mocona05/seoil_uni_project/ESP32/Image/esp32_evkit.png

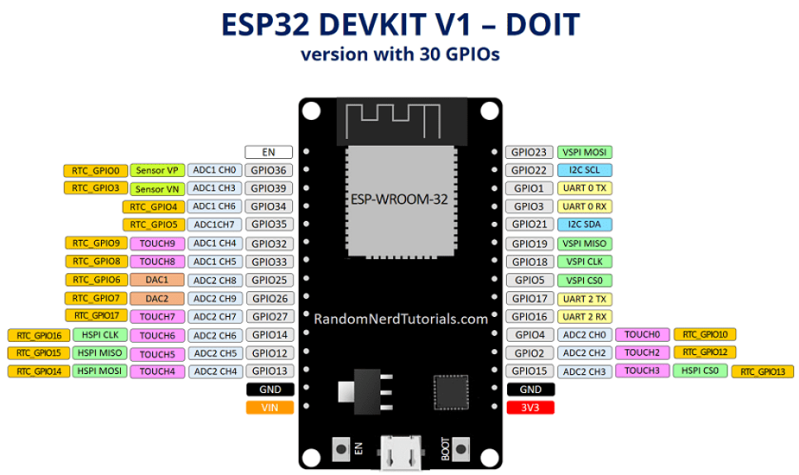
ESP32/Image/esp32_evkit.png
