mocona05/seoil_uni_project/README.md

# seoil_uni_project
서일대학 소프트웨어 공학과 C언어 심화 프로젝트 자료실

목적 : ESP32 EV-KIT 모듈을 사용하여 실습 프로젝트 진행



어댑터 PCB 디자인


어댑터 PCB 회로




온습도 표시 웹서버 실행 화면
