mocona05/seoil_uni_project/ESP32/SW/ARDUINO/Temperature_Humidity_Web_Server/src/readme.txt

hardware : esp32+SHT32 sensor

Temperature & humidity logging
Sensor Status HTML Display
