mocona05/seoil_uni_project/ESP32/DOC/회로 및 데이터쉬트/GY-21evb.pdf

GY-21

## HTU21HumiditySensorModule

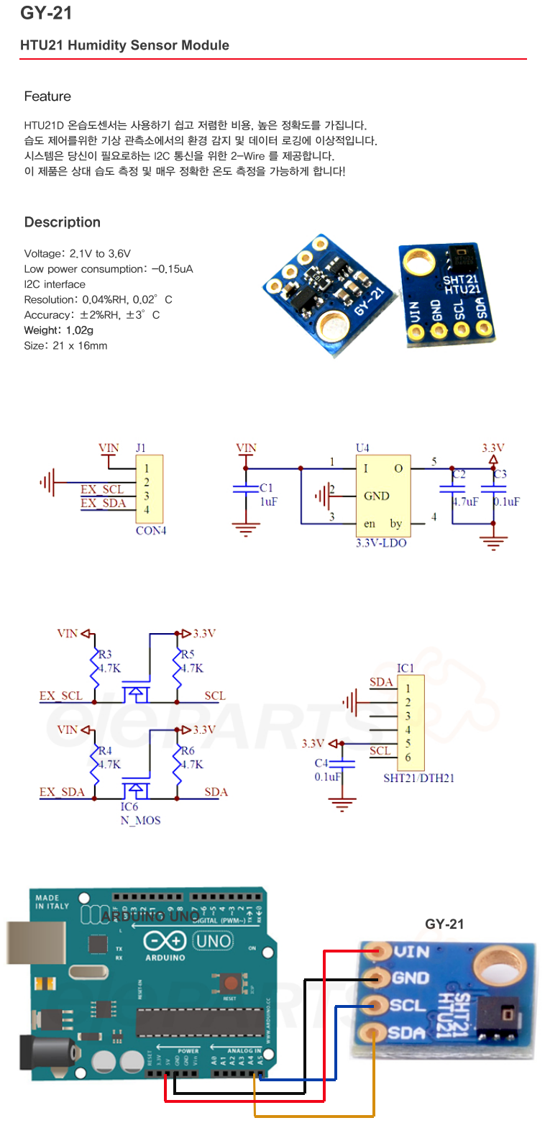
[picture p69: page 1]

## GY-21 ARDUINOUNO

HTU21D온습도센서는 사용하기 쉽고 저렴한 비용,높은 정확도를 가집니다. 습도 제어를위한 기상 관측소에서의 환경 감지 및 데이터 로깅에 이상적입니다. 시스템은 당신이 필요로하는 I2C통신을 위한 2-Wire를 제공합니다.
이 제품은 상대 습도 측정 및 매우 정확한 온도 측정을 가능하게 합니다!

### Feature

### Description

Voltage:2.1Vto3.6V
Lowpowerconsumption:-0.15uA I2Cinterface
Resolution:0.04%RH,0.02°C
Accuracy:±2%RH,±3°C
Weight:1.02g
Size:21x16mm
