mocona05/seoil_uni_project/ESP32/Image/esp32 pcb_3d_image.png

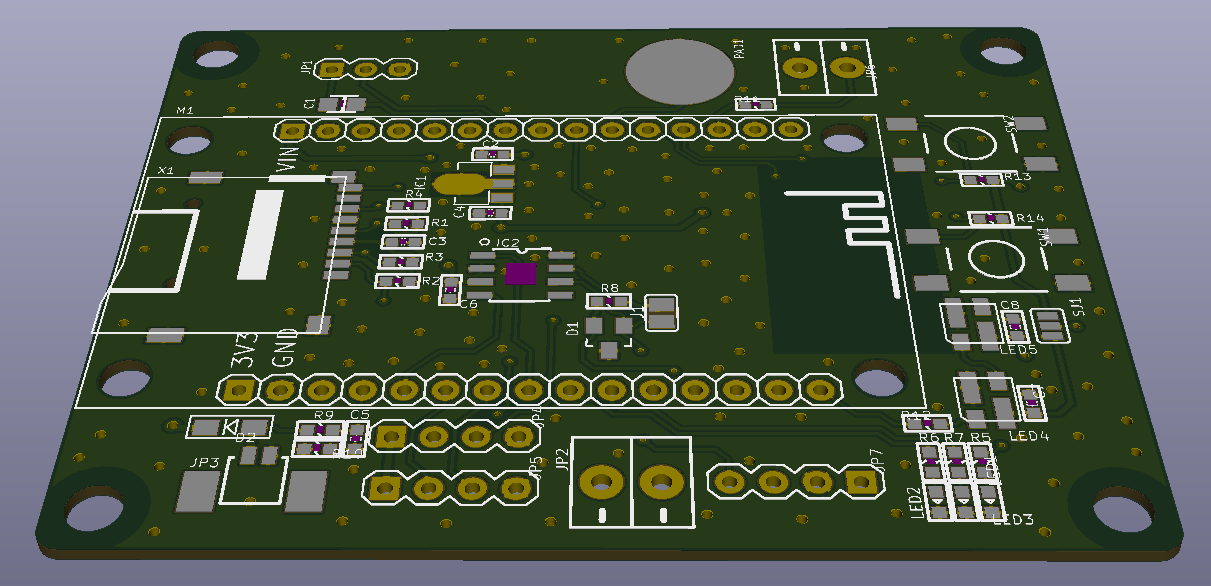
ESP32/Image/esp32 pcb_3d_image.png
