mocona05/seoil_uni_project/ESP32/Image/pcb.png

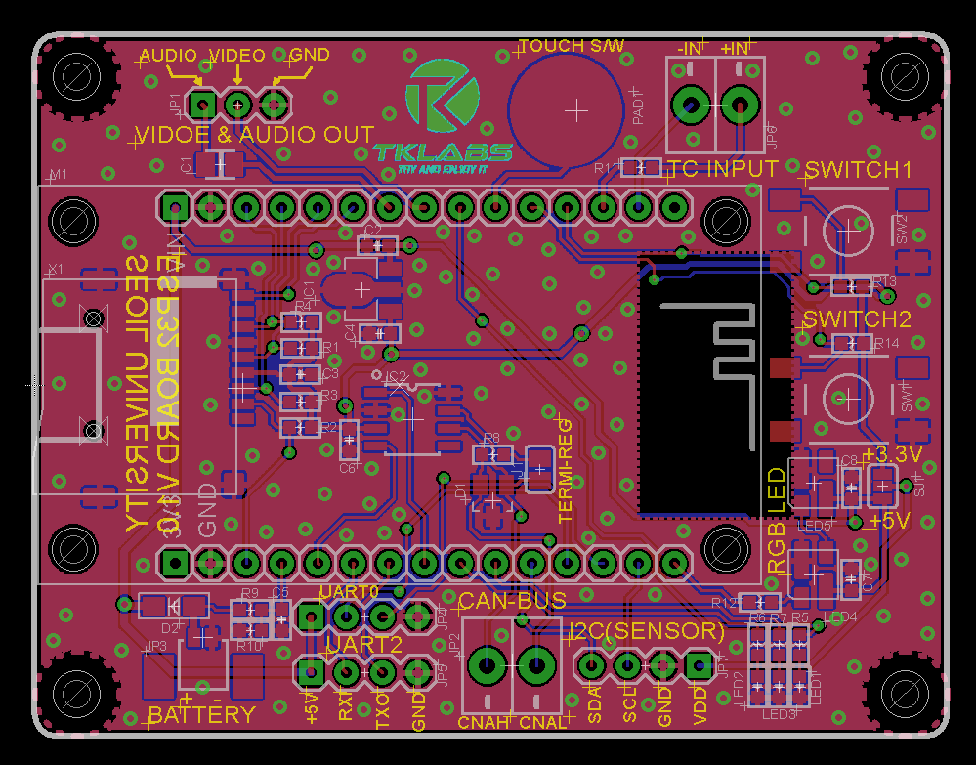
ESP32/Image/pcb.png
