mocona05/seoil_uni_project/ESP32/Image/sch.png

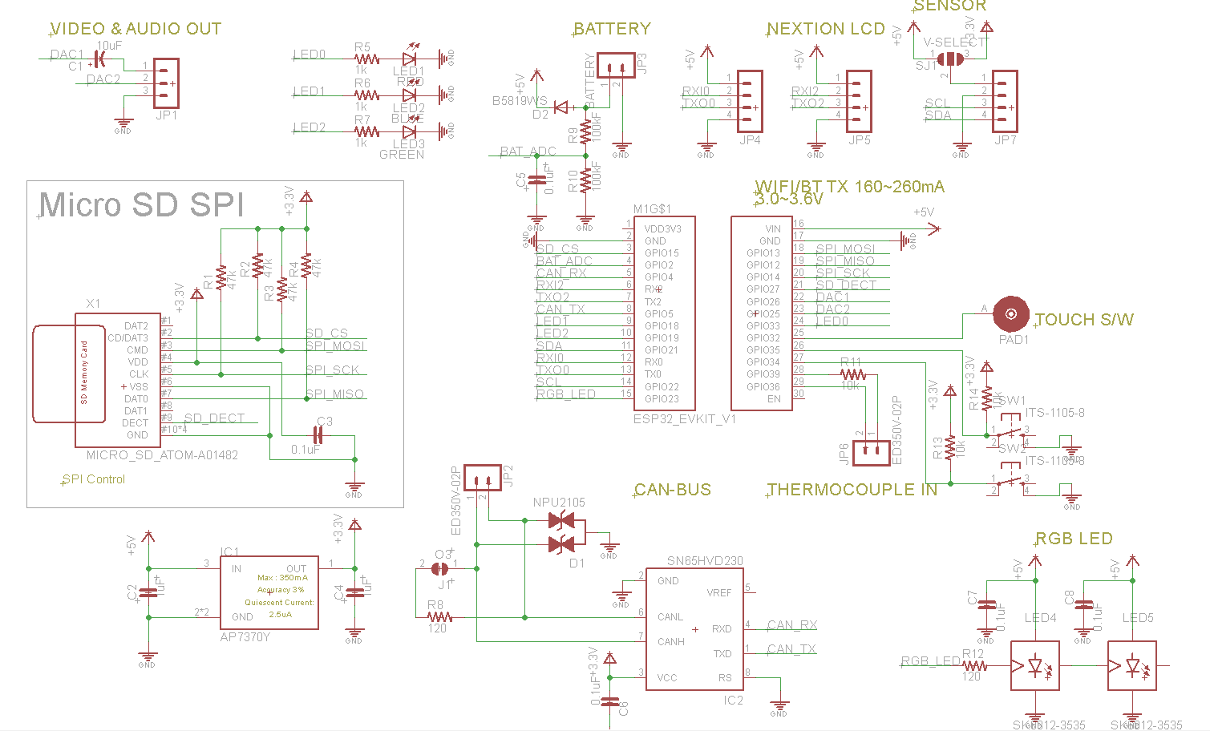
ESP32/Image/sch.png
