mocona05/seoil_uni_project/ESP32/Image/web_page.png

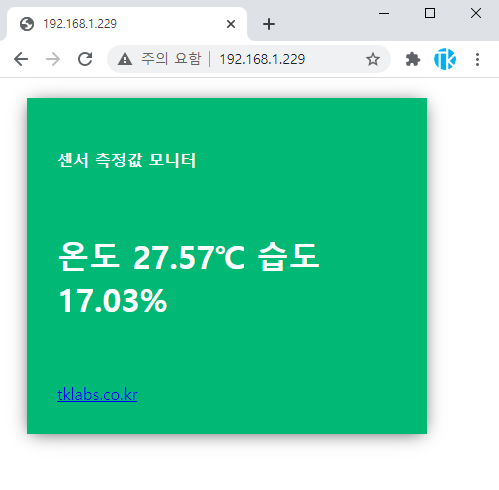
ESP32/Image/web_page.png
