mocona05/seoil_uni_project/ESP32/PCB/kicad/ESP32_EVKIT_v1.0.step

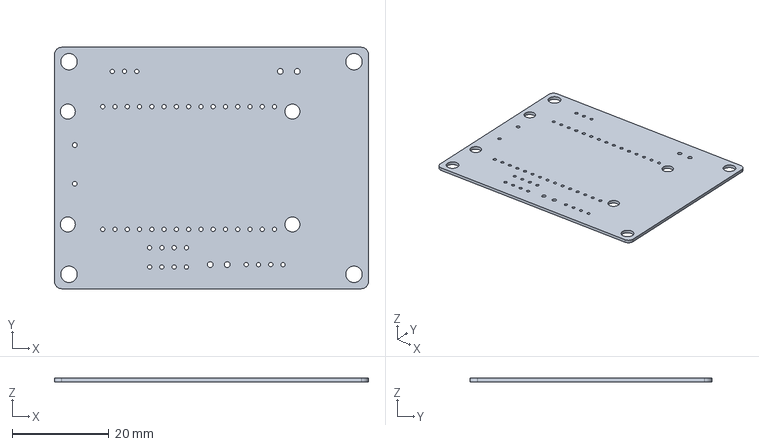
[picture p99: CAD file, 2020-10-19]
ESP32/PCB/kicad/ESP32_EVKIT_v1.0.step
65.0 x 50.0 x 0.8 mm
