mocona05/seoil_uni_project/ESP32/DOC/회로 및 데이터쉬트/esp32_Schematic Prints.pdf

# USB Part

# Power Part

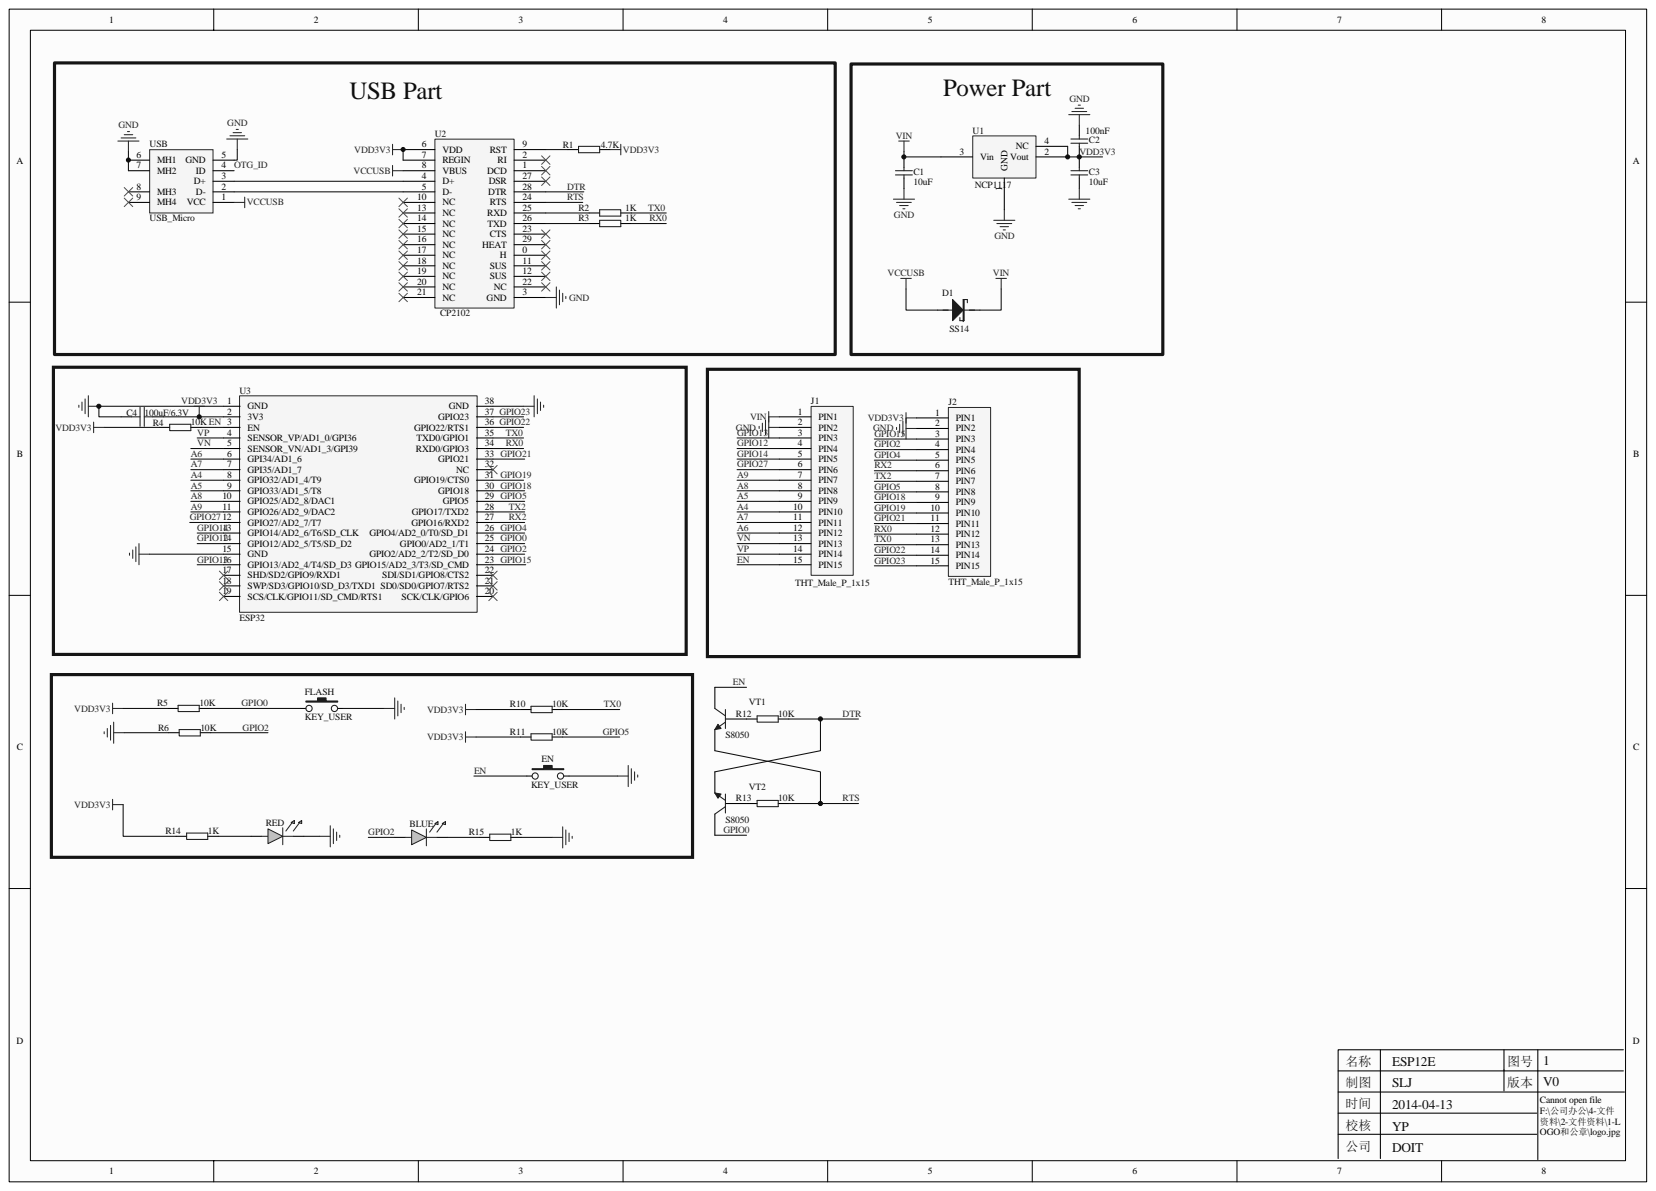
[picture p100: page 1]
