mocona05/seoil_uni_project/ESP32/PCB/EagleCAD/ESP32_EVKIT_v1.0.pdf

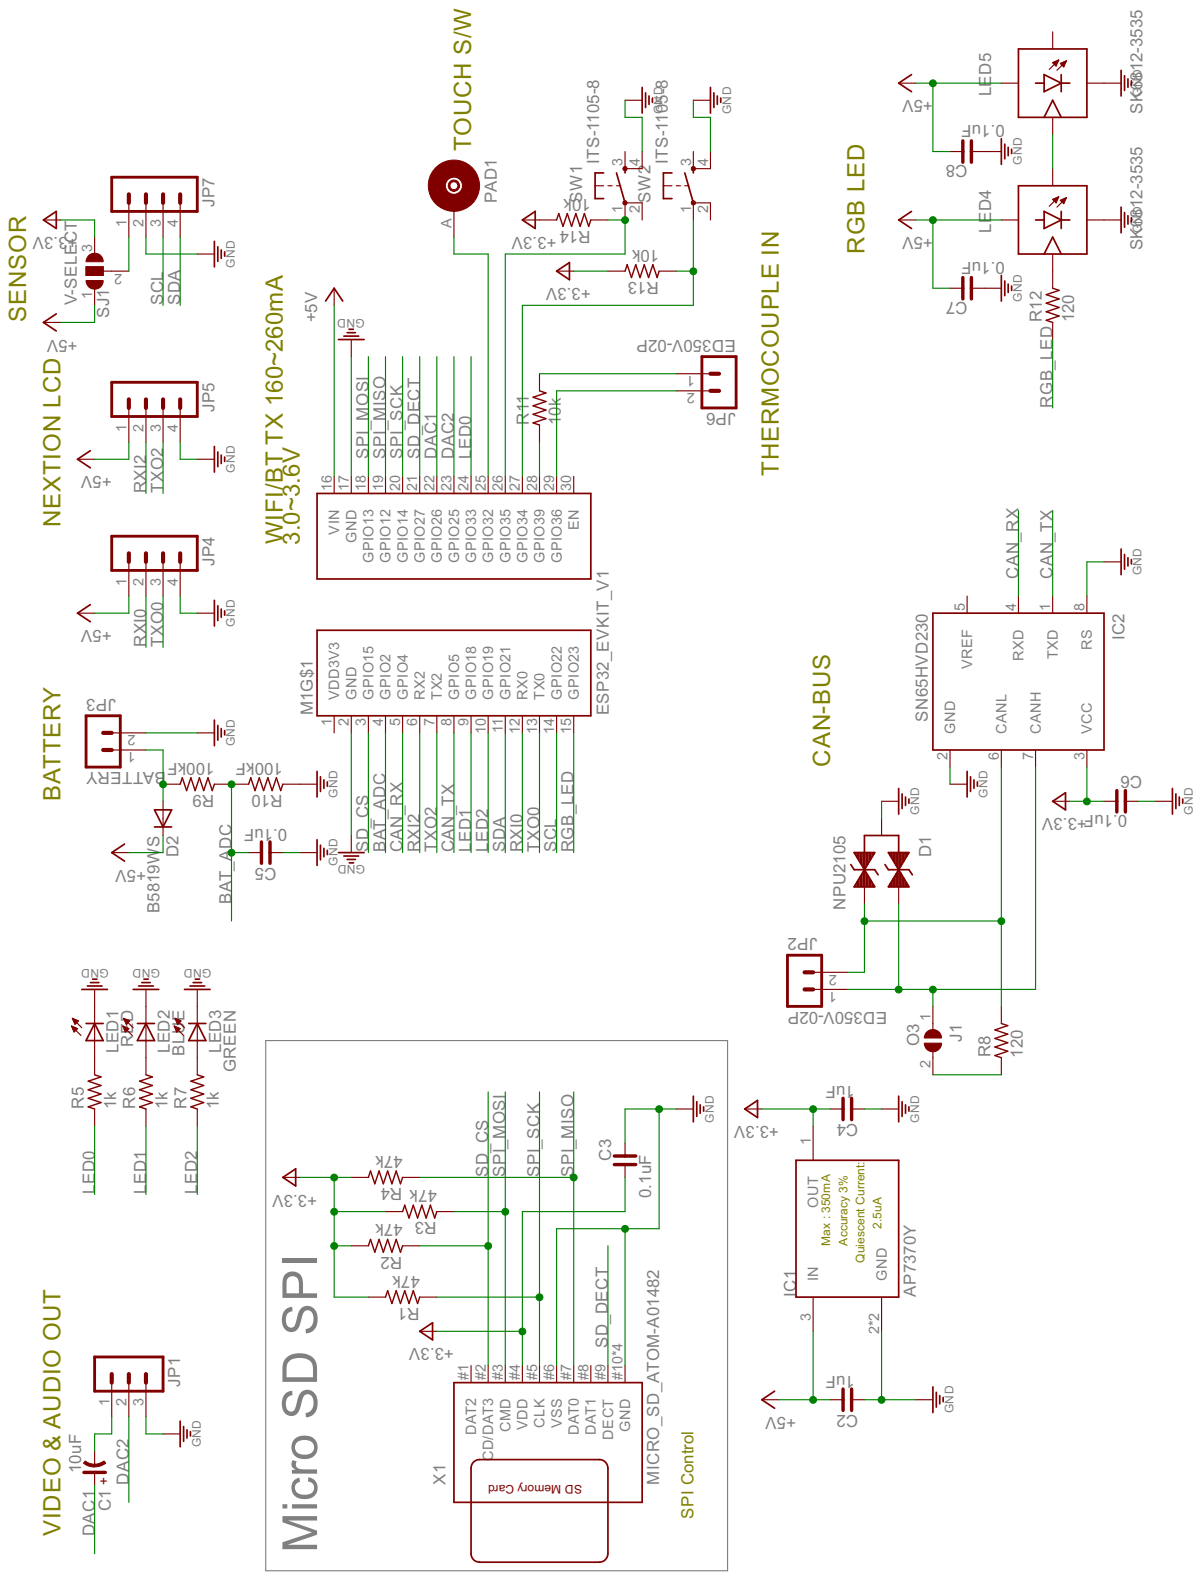
[picture p101: page 1]
