mocona05/seoil_uni_project/ESP32/PCB/EagleCAD/ESP32_EVKIT_v1.0_PCB.pdf

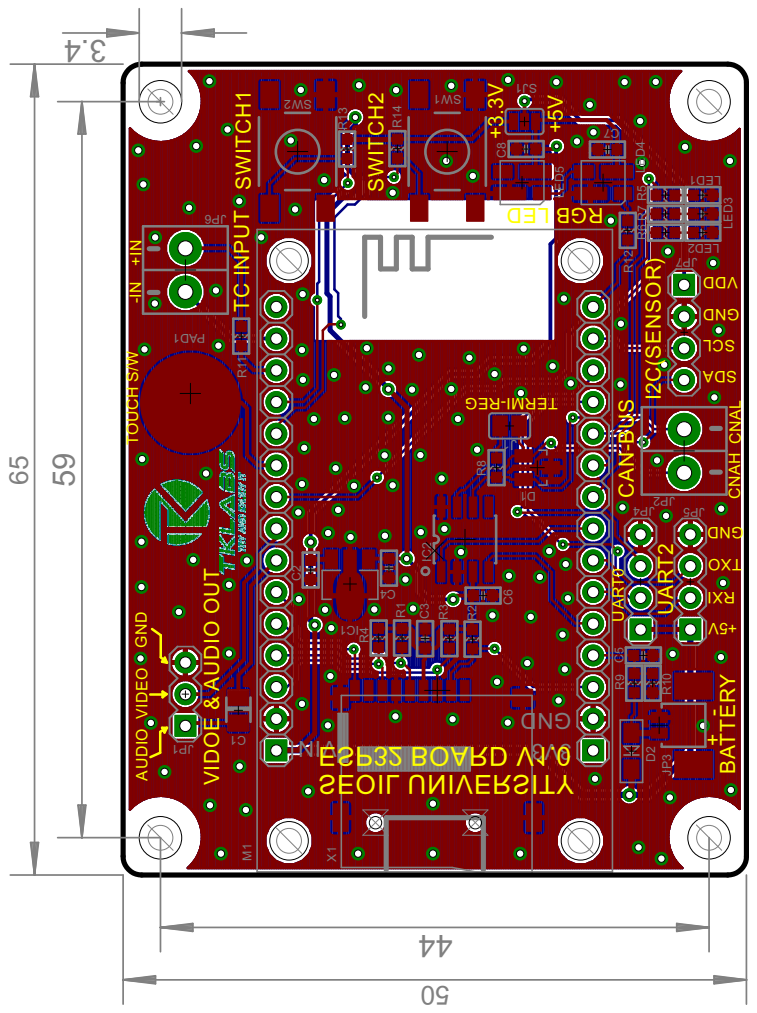
[picture p102: page 1]
