mocona05/seoil_uni_project/ESP32/PCB/kicad/ESP32_EVKIT_v1.0.kicad_pcb

## KiCad design ESP32/PCB/kicad/ESP32_EVKIT_v1.0.kicad_pcb (2020-10-19)

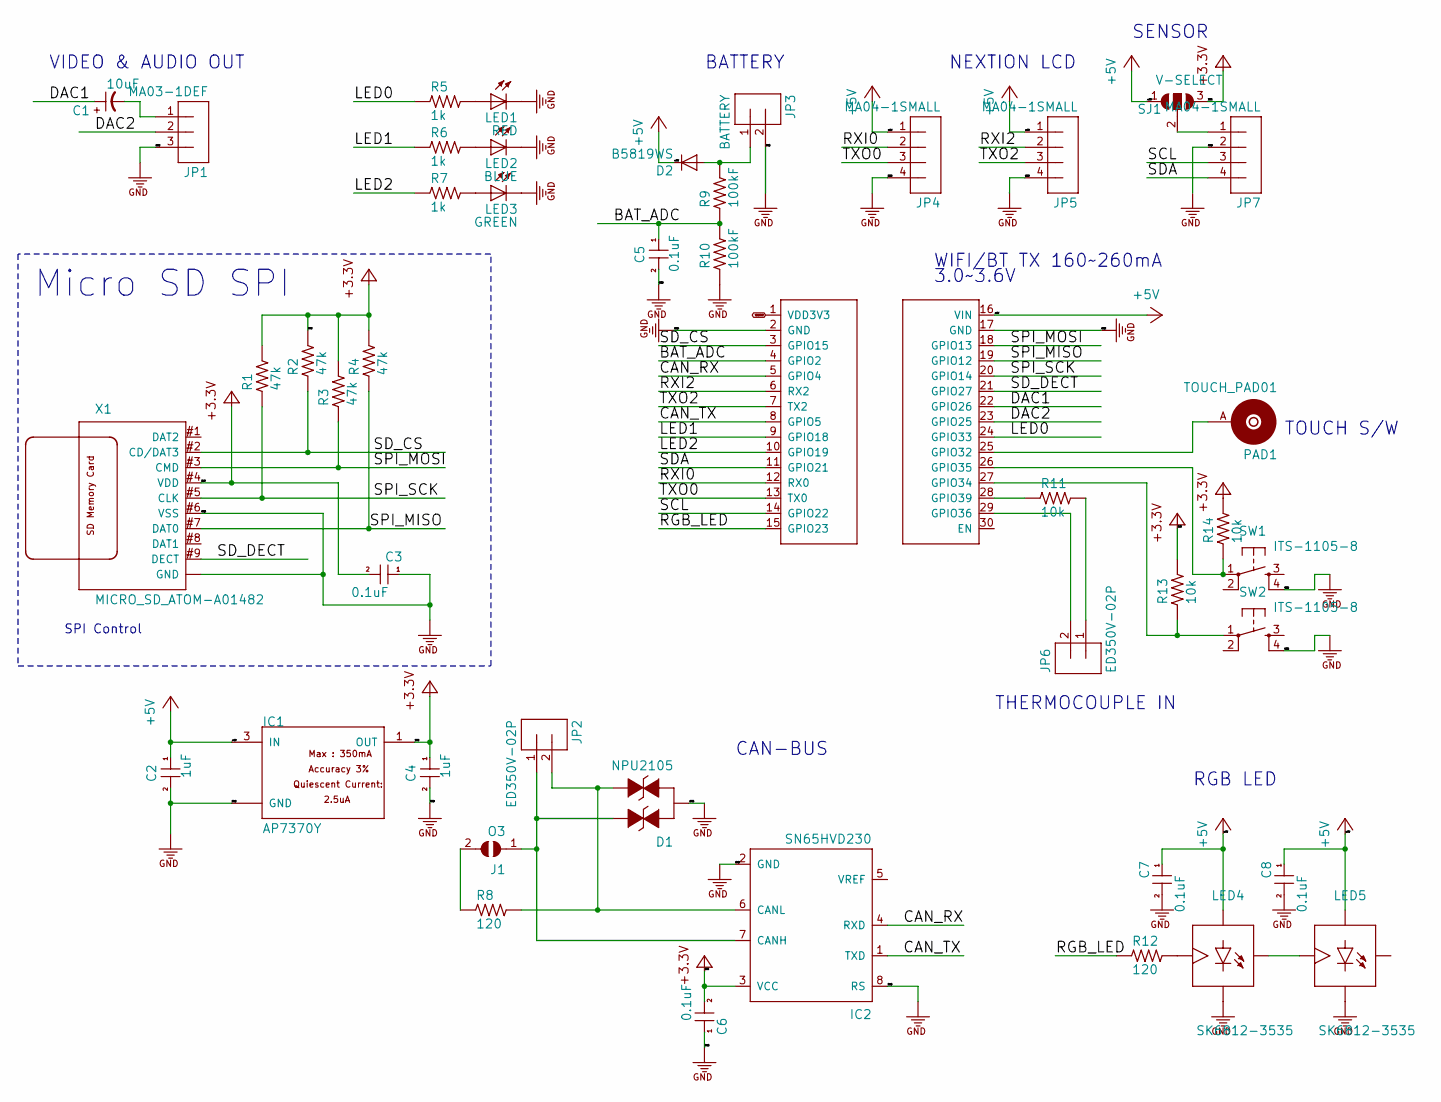
[picture p103: schematic ESP32_EVKIT_v1.0.sch]

Parts:
C1: 10uF; C2012_T
C2, C4: 1uF; C0603
C3, C5, C6, C7, C8: 0.1uF; C0603
D1: NPU2105; SOT23@2
D2: B5819WS; SOD323-W
IC1: AP7370Y; SOT89
IC2: SN65HVD230; SO8
J1: O3; SJ
JP1: MA03-1DEF; MA03
JP2, JP6: ED350V-02P
JP3: BATTERY; 53398-02
JP4, JP5, JP7: MA04-1SMALL; MA04-1-S
LED1: RED; LED-1608
LED2: BLUE; LED-1608
LED3: GREEN; LED-1608
LED4, LED5: SK6812-3535; LED3535
M1: ESP32_EVKIT_V1; ESP32_DEVKIT_V1_DOIT
PAD1: TOUCH_PAD01; TOUCH_PAD1
R1, R2, R3, R4: 47k; R0603
R5, R6, R7: 1k; R0603
R8, R12: 120; R0603
R9, R10: 100kF; R0603
R11, R13, R14: 10k; R0603
SJ1: V-SELECT; SJ_3
SW1, SW2: ITS-1105-8; ITS-1105
X1: MICRO_SD_ATOM-A01482; ATOM-A01482

Connections:
3V3: C3.2, C4.1, C6.2, IC1.1 (OUT), IC2.3 (VCC), R1.2, R2.2, R3.2, R4.2, R13.2, R14.2, SJ1.3, X1.#4 (VDD)
+5V: C2.1, C7.1, C8.1, D2.C, IC1.3 (IN), JP4.1, JP5.1, LED4.4 (VDD), LED5.4 (VDD), M1.16 (VIN), SJ1.1
/BAT_ADC: C5.1, M1.4 (GPIO2), R9.1, R10.2
/CAN_RX: IC2.4 (RXD), M1.5 (GPIO4)
/CAN_TX: IC2.1 (TXD), M1.8 (GPIO5)
/DAC1: C1.+, M1.22 (GPIO26)
/DAC2: JP1.2, M1.23 (GPIO25)
/LED0: M1.24 (GPIO33), R5.1
/LED1: M1.9 (GPIO18), R6.1
/LED2: M1.10 (GPIO19), R7.1
/RGB_LED: M1.15 (GPIO23), R12.1
/RXI0: JP4.2, M1.12 (RX0)
/RXI2: JP5.2, M1.6 (RX2)
/SCL: JP7.3, M1.14 (GPIO22)
/SDA: JP7.4, M1.11 (GPIO21)
/SD_CS: M1.3 (GPIO15), R2.1, X1.#2 (CD/DAT3)
/SD_DECT: M1.21 (GPIO27), X1.#9 (DECT)
/SPI_MISO: M1.19 (GPIO12), R4.1, X1.#7 (DAT0)
/SPI_MOSI: M1.18 (GPIO13), R3.1, X1.#3 (CMD)
/SPI_SCK: M1.20 (GPIO14), R1.1, X1.#5 (CLK)
/TXO0: JP4.3, M1.13 (TX0)
/TXO2: JP5.3, M1.7 (TX2)
GND: C2.2, C3.1, C4.2, C5.2, C6.1, C7.2, C8.2, D1.D (PIN3), IC1.2 (GND), IC1.2@1 (GND), IC2.2 (GND), IC2.8 (RS), JP1.3, JP3.2, JP4.4, JP5.4, JP7.2, LED1.C, LED2.C, LED3.C, LED4.2 (VSS), LED5.2 (VSS), M1.2 (GND), M1.17 (GND), R10.1, SW1.4, SW2.4, X1.#6 (VSS), X1.#10 (GND), X1.#10@ (GND), X1.#10@1 (GND), X1.#13 (GND)
unnamed: C1.-, JP1.1
unnamed: D1.G (PIN1), IC2.7 (CANH), J1.1, JP2.1
unnamed: D1.S (PIN2), IC2.6 (CANL), JP2.2, R8.2
unnamed: D2.A, JP3.1, R9.2
unnamed: J1.2, R8.1
unnamed: JP6.1, R11.2
unnamed: JP6.2, M1.29 (GPIO36)
unnamed: JP7.1, SJ1.2
unnamed: LED1.A, R5.2
unnamed: LED2.A, R6.2
unnamed: LED3.A, R7.2
unnamed: LED4.1 (DOUT), LED5.3 (DIN)
unnamed: LED4.3 (DIN), R12.2
unnamed: M1.25 (GPIO32), PAD1.A
unnamed: M1.26 (GPIO35), R14.1, SW1.1
unnamed: M1.27 (GPIO34), R13.1, SW2.1
unnamed: M1.28 (GPIO39), R11.1
VDD3V3: M1.1 (VDD3V3)

Notes on the sheet:
3.0~~3.6V
WIFI/BT TX 160~~260mA
Micro SD SPI
SPI Control
VIDEO & AUDIO OUT
NEXTION LCD
SENSOR
TOUCH S/W
RGB LED
CAN-BUS
BATTERY
THERMOCOUPLE IN

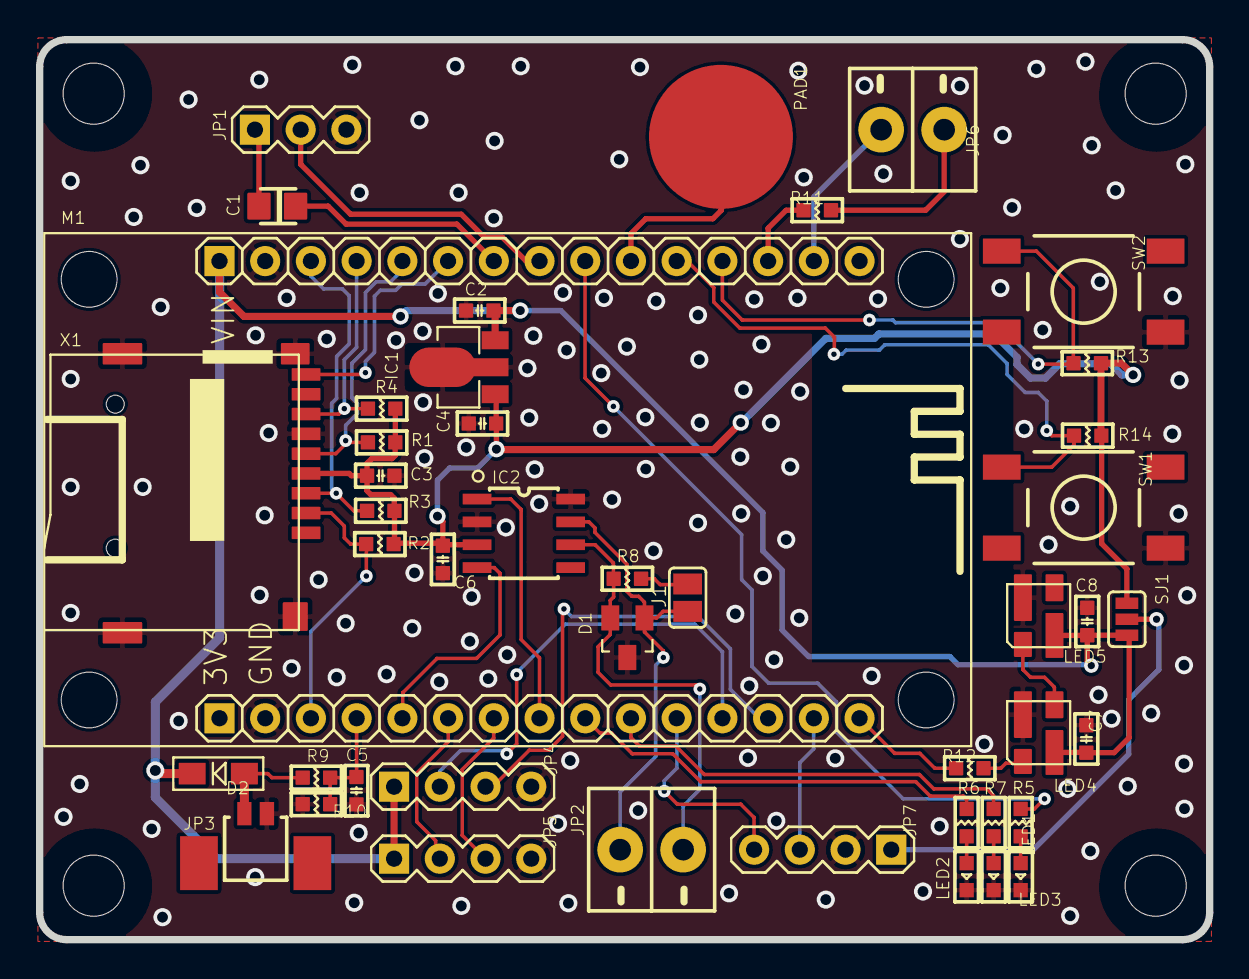
[picture p104: board ESP32_EVKIT_v1.0.kicad_pcb from above]

Board: 2 copper layers, 65.0 x 50.0 mm, 49 parts (0 on the bottom side), 40 nets.

Other parts of the board:
@HOLE0, @HOLE1, @HOLE2, @HOLE3: (no value)
