mocona05/seoil_uni_project/ESP32/SW/ARDUINO/MQTT/src/main.cpp

#include <WiFi.h>
#include "Arduino.h"
#include "gpio.h"
#include "board.h"
#include "drv_sht21.h"
#include "PubSubClient.h"
#include "mqtt.h"





void setup() {
  Serial.begin(115200);
  gpio_init();
  sht21_init(SCL_PIN, SDA_PIN);
  setup_wifi();
  mqtt_init();

}

void loop() {
  float temp, humi;
//  char buff[50];

  if(temp_humi_Measure_Handler(&temp, &humi)) {
    mqtt_handler(humi, temp);
//    sprintf(buff,"temp=%.2f, humi=%.2f\r\n", temp, humi);
//    Serial.print(buff);
    RED_LED_TOGGLE;
  }
    delay(1);   //esp32의 arduino frame work 는 Free rtos가 포팅되어 있어 delay가 없을 경우 os 리소스 반환이 없어 문제가 되어 삽입
}
