mocona05/seoil_uni_project/ESP32/SW/Espressif/dht_21_sensor_reading_espressif32/src/drv_touch.h

#pragma once

#define TOUCH_PAD_NO_CHANGE   (-1)
#define TOUCH_THRESH_NO_USE   (0)
#define TOUCH_FILTER_MODE_EN  (0)
#define TOUCHPAD_FILTER_TOUCH_PERIOD (10)

void touch_init(void);
void tp_read_handler(void);
