mocona05/seoil_uni_project/(commit log)

2020-10-15 자료업로드
    [ESP32_EVKIT_v1.0.brd, ESP32_EVKIT_v1.0.sch]
2020-10-15 esp32 sd logger arduino sw add
    esp32용 sd logger & html 상태표시 소프트웨어 추가
2020-10-15 datasheet 추가
2020-10-15 온습도 web server 메뉴얼 업로드
2020-10-19 Platformio source upload
    vs code Platformio 용 소드코드 등록
    [ESP32_EVKIT_v1.0.sch]
2020-10-19 KICAD 파일 등록
    [ESP32_EVKIT_v1.0.brd, ESP32_EVKIT_v1.0.kicad_pcb, ESP32_EVKIT_v1.0.sch, ESP32_EVKIT_v1.0.step]
2020-10-25 메뉴얼 업로드
    [ESP32_EVKIT_v1.0.brd, ESP32_EVKIT_v1.0.sch]
2020-10-26 esp32 espressif32 source code upate
    espressif32 의 네이티브 센서 동작 기본소스 led 시간 수정
    [main.c]
2020-10-28 아두이노 예제 가져오기 메뉴얼 업로드
2020-10-28 예제 생성 문서2 업로드
2020-10-28 메뉴얼 수정
2020-11-04 수업업로드
2020-11-10 Platform Io 설치메뉴얼 업로드
2020-11-11 예제코드 업로드
    [ESP32_EVKIT_v1.0.brd]
2020-11-11 예제코드 및 수업자료 업로드
2020-11-11 드라이버 업로드
2020-11-11 문서자료 업로드 및 드라이버 등록
2020-11-13 platform Io 설치 메뉴얼 업로드
2020-11-17 PCB TEST CODE UPDATE
    [ESP32_EVKIT_v1.0.brd, ESP32_EVKIT_v1.0.sch]
2020-11-18 ARDUINO 예제 자료 업로드
    [ESP32_EVKIT_v1.0.brd, ESP32_EVKIT_v1.0.sch]
2020-11-18 수업전 자료업로드
2020-11-24 예제업로드
2020-11-25 강의전 업로드
2020-11-25 문서다시정리
2020-11-25 11월25일 수업중 작성 예제 업로드
2020-12-02 강의전 업데이트
2020-12-02 자료내용추가
2020-12-02 12월 2일 수업 중 예제 업로드 (BlueTooth_remote)
2020-12-09 수업전 업데이트
2020-12-30 MQTT 테스트 소스 및 문서 등록
2020-12-31 MQTT 예제수정
